Scienceche/microduck-community-kit/docs/wechat.jpg

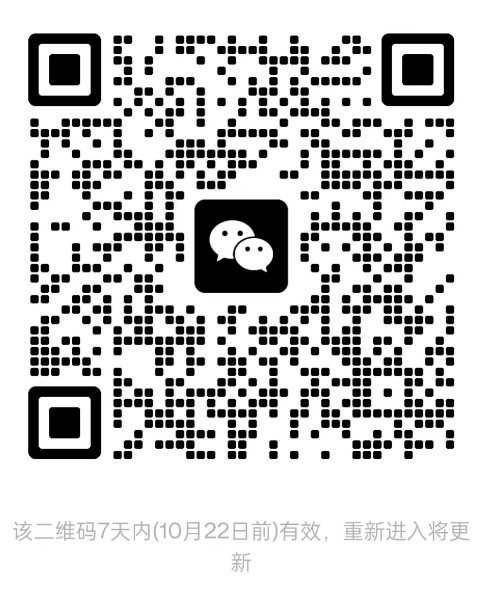
docs/wechat.jpg
