Scienceche/microduck-community-kit/hardware/imu_to_dxl/production/bom.csv

Designator | Footprint | Quantity | Value | LCSC Part #
C1 | C0402 | 1 | 100p | C106200
C10, C11 | C0402 | 2 | 20pF/50V | C107000
C12, C13, C14, C15, C16, C18, C19, C2, C7, C8, C9 | C0402 | 11 | 100nF/16V | C1525
C17 | C0402 | 1 | 27pF/50V | C107002
C20, C21 | C0402 | 2 | 1uF/10V | C106254
C22 | C0402 | 1 | 1nF/50V | C106205
C5 | C0603 | 1 | 22uF/6.3V | C59461
C6 | C0805 | 1 | 10uF/50V | C2932476
D1 | SMA_L4.4-W2.6-LS5.0-RD | 1 | SMAJ36A | C353452
D2 | SOD-323_L1.7-W1.3-LS2.5-BI | 1 | 5V ESD | C19224
F1 | F0603 | 1 | PTC(40R) | C2687114
L1 | IND-SMD_L3.0-W3.0_SWPA3010S | 1 | 10uH/920mA | C45403
LED1 | LED0603-RD | 1 | GL0603UG01
Q1 | SOT-23 | 1 | MMBT3906 | C727128
R1 | R0402 | 1 | 75K | C144737
R10, R11, R12, R13, R17, R18, R2, R21, R22, R23, R24, R25, R26 | R0402 | 13 | 51R | C137960
R14 | R0402 | 1 | 1K | C11702
R15, R16, R19, R27, R28, R30, R7, R8 | R0402 | 8 | 10K | C25744
R29 | R0402 | 1 | 20k | C25765
R3, R31, R34 | R0402 | 3 | 100K | C25741
R32, R9 | R0402 | 2 | 0R | C60485
R35 | R0402 | 1 | 1M | C26083
R5 | R0603 | 1 | 0R | C21189
R6 | R0402 | 1 | 24K | C138026
U1 | SOT-23-6_L2.9-W1.6-P0.95-LS2.8-BR | 1 | ETA2845S2G_C22362741 | C22362741
U2 | LQFP-48_L7.0-W7.0-P0.50-LS9.0-BL | 1 | GD32F303CCT6 | C116151
U3 | LGA-14_L3.0-W2.5-P0.50-BR | 1 | LSM6DSV16XTR | C5267406
U4 | SOT-23-5 | 1 | SN74LVC1G126DBVR | C46472327
U5 | SOT-23-5 | 1 | SN74LVC1G125DBV | C3040625
U6 | SOT-23-5_L3.0-W1.7-P0.95-LS2.8-BR | 1 | ME6211C18M5G-N | C236671
X1 | CRYSTAL-SMD_4P-L3.2-W2.5-BL | 1 | XL2EL89CSI-111YLC-12M | C5280576
