Scienceche/microduck-community-kit/(commit log)

2026-10-11 修改IMU工作电压到5V；拼板文件优化
    [bom.csv, imu_to_dxl.kicad_sch, imu_to_dxl_10p.kicad_pcb]
2026-10-15 更正原理图规格型号
    [dxl_hub.kicad_sch]
2026-10-15 更新dxl_hub飞特插座型号
2026-10-16 更新imu_to_dxl:1、优化MCU晶震电路；2、增加调试知识灯
    [bom.csv, designators.csv, imu_to_dxl.kicad_pcb, imu_to_dxl.kicad_sch, imu_to_dxl_10p.kicad_pcb, positions.csv]
